antaramazumdar/bike-light/README.md

### Bike Light
Antara Mazumdar, Ammara Hussain, Naomi Francis
